Yegor12345/Analog_electronics/Курсовая работа/Фото и скриншоты/Макет фото 2.jpg

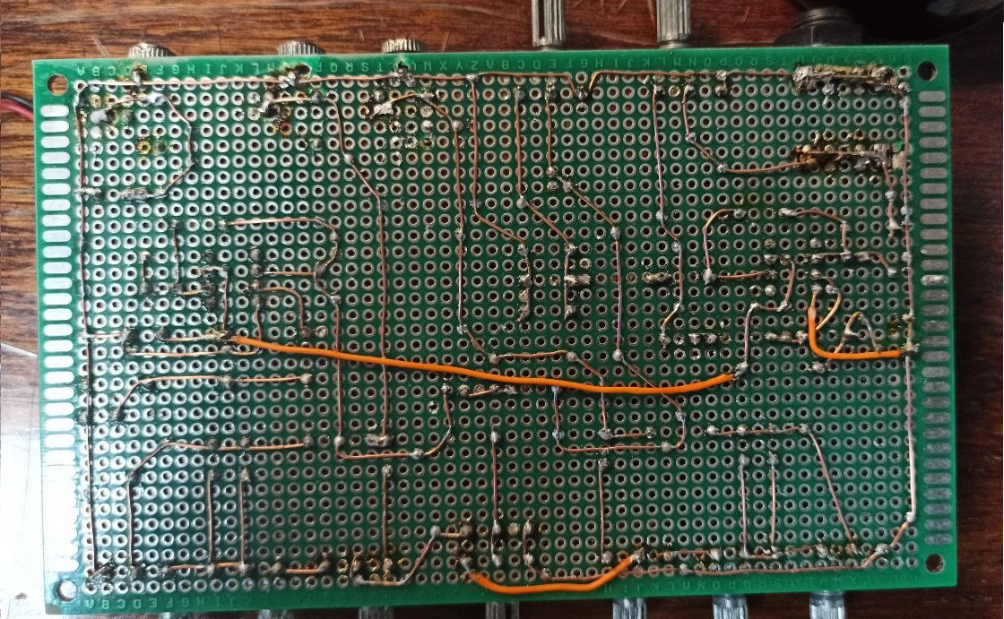
Курсовая работа/Фото и скриншоты/Макет фото 2.jpg
