Yegor12345/Analog_electronics/README.md

# Analog_electronics
Роботи з дисципліни: Аналогова електроніка
