Yegor12345/Analog_electronics/Bodak_lab_1.pdf

МІНІСТЕРСТВО ОСВІТИ І НАУКИ УКРАЇНИ

НАЦІОНАЛЬНИЙ ТЕХНІЧНИЙ УНІВЕРСИТЕТ УКРАЇНИ «КИЇВСЬКИЙ ПОЛІТЕХНІЧНИЙ ІНСТИТУТ

імені ІГОРЯ СІКОРСЬКОГО»

Кафедра: КЕОА

Курс:. “Аналогова електроніка - 1”.

Лабораторна робота № 1

Тема: Дослідження суматора напруг на резисторах, RC ланцюжка та RC фільтрів

Виконав:

Ст. групи ДК-92

бригада №7

Бодак Єгор

Київ 2020

Лабораторна робота №1

Тема: “Дослідження суматора напруг на резисторах, RC ланцюжка та RC фільтрів”

### 1.1. Практичне застосування досліджуваних схем

Суматор напруг на резисторах не є дуже розповсюдженою схемою, але це гарна схема яка

має ефектний результат роботи та дозволяє одержати практику користування макетною платою і

згадати методи розрахунку електричних кіл з джерелами напруги і резисторами. Суматор напруг

можна використовувати у якості найпростішого мікшера для додавання довільних електричних

сигналів у вигляді напруг. А можна на базі суматора напруг створити примітивний калькулятор

для додавання і віднімання чисел (якщо поставити у відповідність кожному числу певну напругу).

Числа на вході можна задавати за допомогою регульованих джерел напруги, а результат зчитувати

за допомогою вольтметру.

RC ланцюжки, дуже широко використовуються в електроніці, оскільки обумовлюють

затримки розповсюдження напруг через схему (напруга змінюється не моментально, а лише після

заряду/розряду ємності, для чого необхідний час, що і обумовлює затримку). Вихід будь якої

лінійної схеми можна замінити моделлю у вигляді джерела напруги з послідовно підключеним

до нього вихідним опором схеми. Вхід будь якої схеми має вхідну ємність. З’єднувальні

провідники на друкованій платі також мають певну ємність. Якщо підключити вихід однієї схеми

до входу іншої схеми, одержимо RC ланцюжок і напруга на вході другої схеми буде змінюватись

не моментально, а у міру заряду-розряду вхідної ємності. Зокрема RC ланцюжки визначають

затримку розповсюдження сигналу всередині мікросхем і врешті решт максимально допустиму

тактову частоту. Також RC ланцюжок можна застосовувати для автоматичного зкидання (ресету)

цифрових схем (наприклад, мікроконтролерів).

RC фільтри є найпростішим типом фільтрів. А фільтри в електроніці використовуються

дуже широко. Наприклад для прибирання з аналогового сигналу шумів та наводок, на вході

аналого-цифрового перетворювача

ХІД РОБОТИ

### 1.2. Завдання на лабораторну роботу

1. Дослідження суматора напруг на резисторах
1.1. Побудувати суматор напруг на 2 входи з резисторів однакових номіналів (рис.1.1). Для

гарного узгодження за напругою та з метою зниження струму, що протікатиме у колі,

номінали резисторів необхідно обирати порядку кількох десятків КОм (50-100КОм);

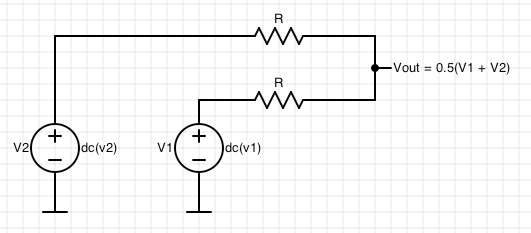
[picture p3: figure]

Рис.1.1. Схема суматора напруг на резисторах

Резистори по 10кОм

1.2. Подати на вхід дві довільні напруги з джерел постійної напруги та за допомогою

вольтметру виміряти напругу на виході суматора. Порівняти одержане значення з

теоретичним результатом Uвих = (U1 + U2)/2. Результати вимірювань занести до

протоколу.

На вхід подаємо напруги 1В та 2В, на виході маємо отримати:

(1В + 2В) / 2 = 1.5 В

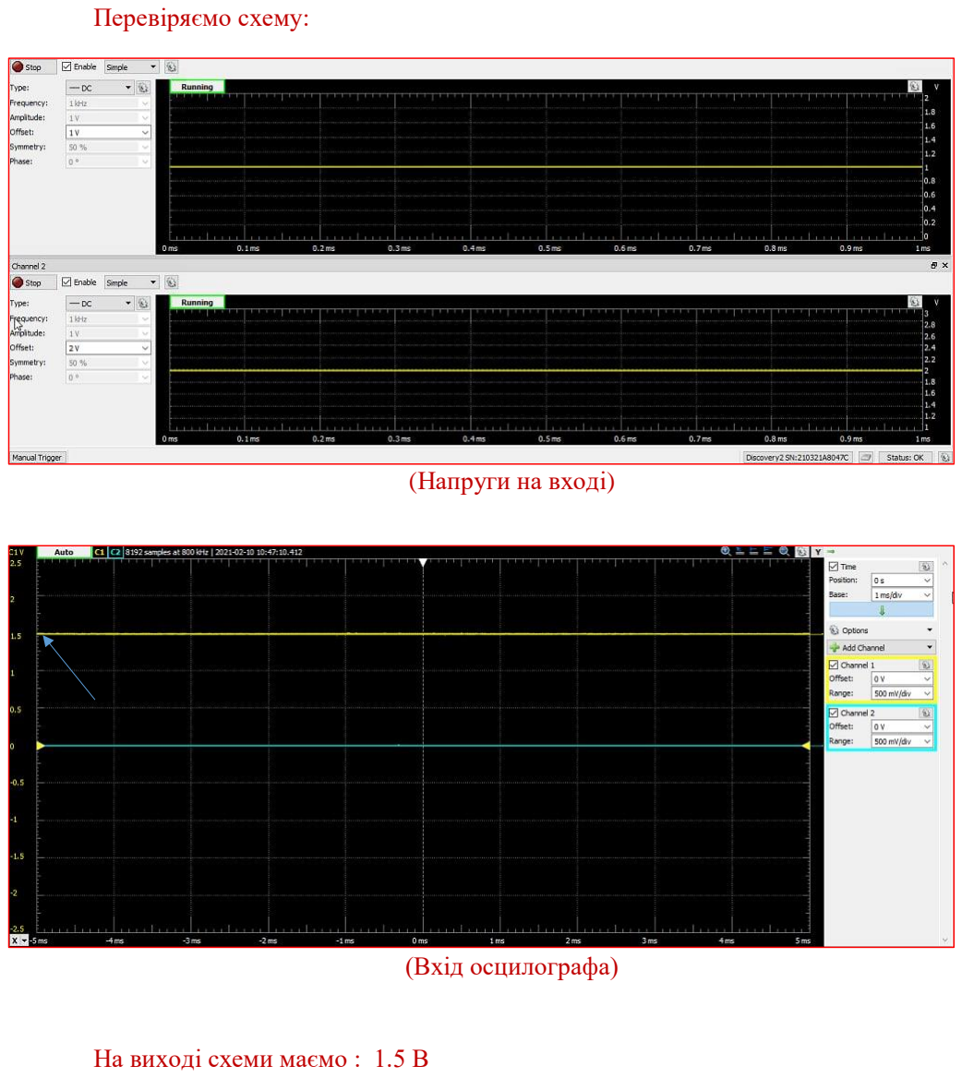
[picture p4: page 4]

Перевіряємо схему:

(Напруги на вході)

(Вхід осцилографа)

На виході схеми маємо : 1.5 В

1.3. Промоделювати роботу суматора в LTSpice для тих же вхідних напруг, що були

використані при проведенні вимірювань на реальних приладах. Порівняти одержані

результати з результатами реальних вимірювань. Результати симуляції (схема, графіки)

занести до протоколу.

LTSpice:

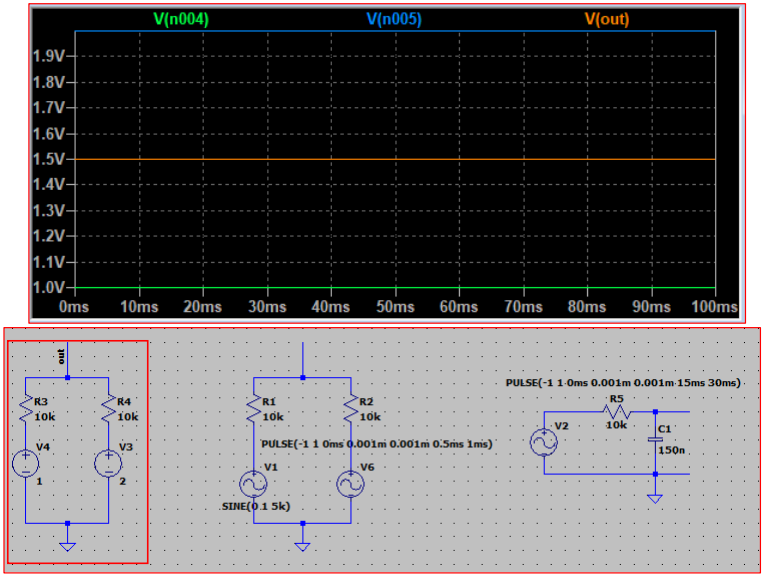
[picture p5: figure]

1.4. Подати на входи суматора два сигнали з генераторів ГЗ-112. Перший сигнал

імпульсний (меандр) з частотою 1 КГц, амплітудою 1В. Другий сигнал синусоїдальний з

частотою 5 КГц, амплітудою 1В. За допомогою двохпроменевого осцилографа необхідно

зафіксувати сигнали на входах суматора (сфотографувати картинку) та сигнал на виході

суматора (сфотографувати картинку). При цьому необхідно записати налаштування

осцилографа на яких ви проводили вимірювання (В/поділку, час/поділку) та параметри

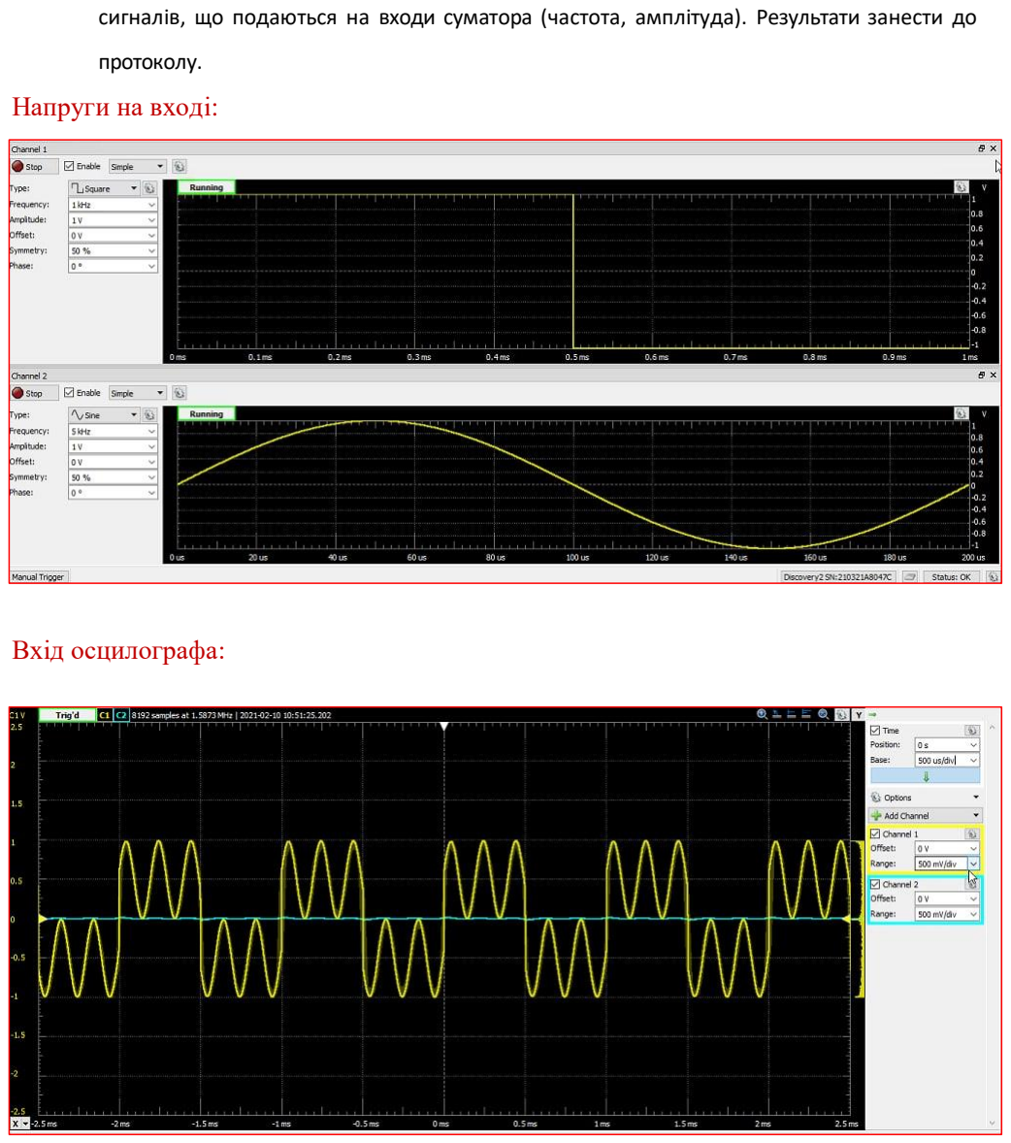
[picture p6: page 6]

сигналів, що подаються на входи суматора (частота, амплітуда). Результати занести до

протоколу.

Напруги на вході:

Вхід осцилографа:

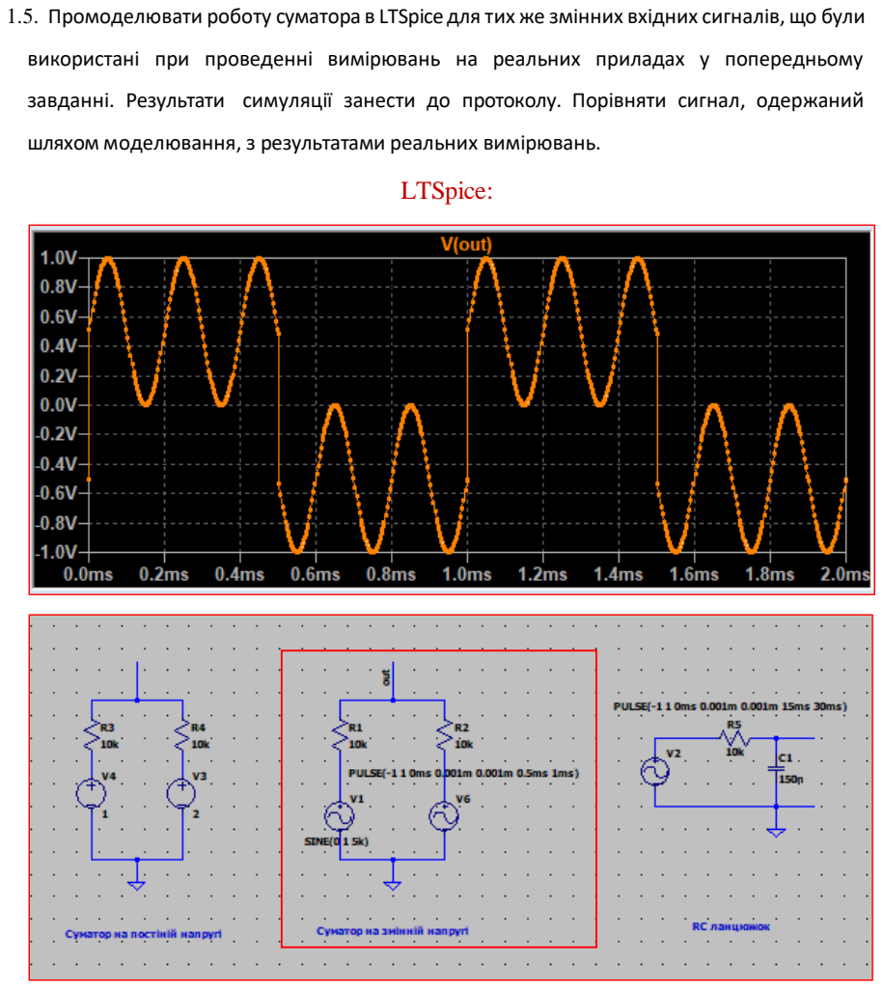
[picture p7: page 7]

1.5. Промоделювати роботу суматора в LTSpice для тих же змінних вхідних сигналів, що були

використані при проведенні вимірювань на реальних приладах у попередньому

завданні. Результати симуляції занести до протоколу. Порівняти сигнал, одержаний

шляхом моделювання, з результатами реальних вимірювань.

LTSpice:

### 2. Дослідження RC ланцюжка

2.1. Скласти схему RC ланцюжка для довільних значень ємності і опору (опір резистора

можна брати порядку кілоома, ємність конденсатора порядку десятківнанофарад).

R= 10кОм

C= 150нФ

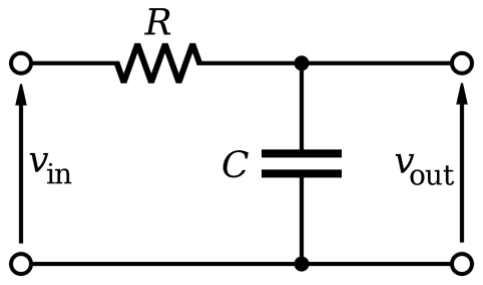
[picture p8: figure]

2.2. Розрахувати тривалість заряду та розряду ємності для цього ланцюжка. Результати

занести до протоколу.

T = R * С = 10 * 10³ * 150 * 10⁻⁹ = 1,5 мс

5Т = 5 * 1,5 = 7,5 мс

2.3 Подати на вхід RC ланцюжка імпульсну напругу з генератора ГЗ-112 з амплітудою 1 В та

такою частотою, щоб період був в 4-6 разів більший за розраховану тривалість заряду-

розряду. На двохпроменевому осцилографі подивитися на вхідний та вихідний сигнали RC

ланцюжка (сфотографувати картинку). Записати налаштування осцилографа на яких ви

проводили вимірювання (В/поділку, час/поділку) та параметри імпульсного сигналу.

Перевірити, що тривалість заряду-розряду дорівнює розрахованому значенню. Результати

вимірювань занести до протоколу.

Знайдемо період більший у 4 рази: 4 * Т = 4 * 7,5 = 30 мс

Розрахуємо частоту: f = 1/T = 1/30 * 10⁻³ = 33.3 H

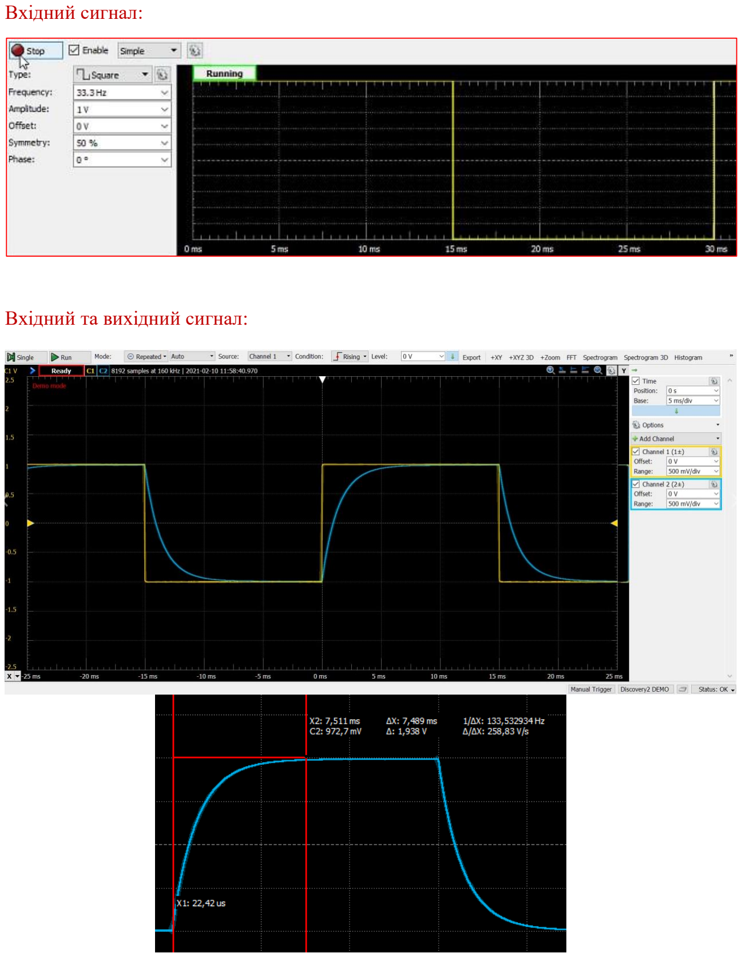
[picture p9: page 9]

Вхідний сигнал:

Вхідний та вихідний сигнал:

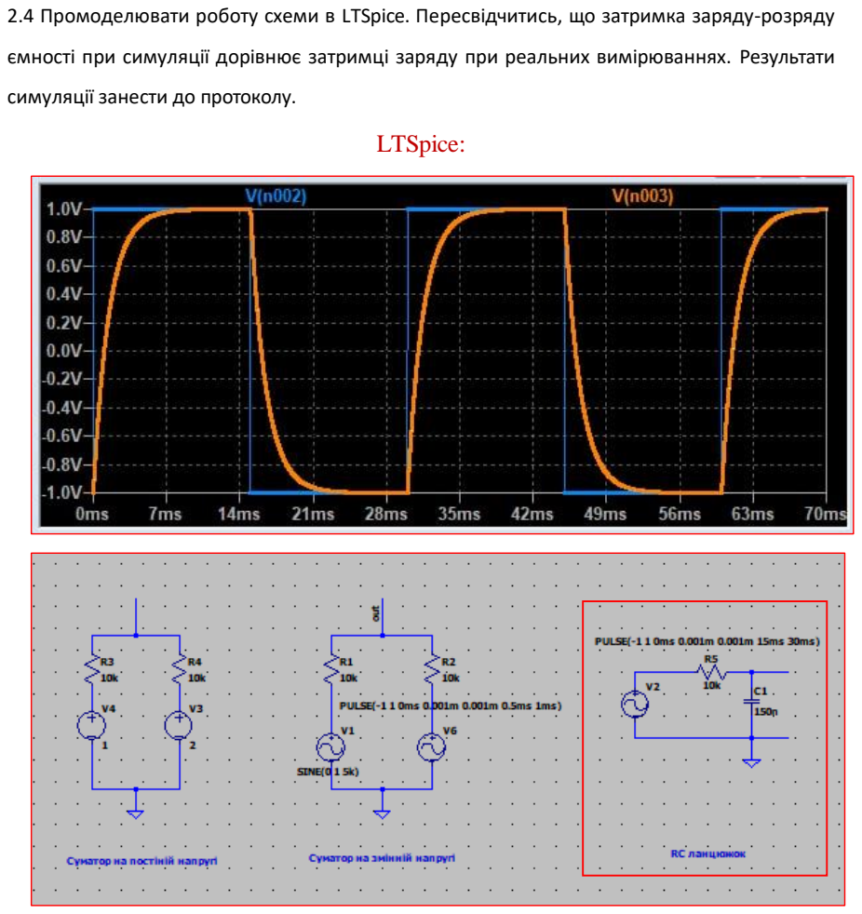
[picture p10: page 10]

2.4 Промоделювати роботу схеми в LTSpice. Пересвідчитись, що затримка заряду-розряду

ємності при симуляції дорівнює затримці заряду при реальних вимірюваннях. Результати

симуляції занести до протоколу.

LTSpice:

3. Дослідження RC фільтру низької частоти.
3.1. Скласти схему RC фільтру низької частоти для довільних значень опору і ємності.
3.2. Розрахувати значення частоти зрізу. Результат занести до протоколу.

fc =

1

## 2πRC

=

1

## 2π ∗ 10 ∗ 10³ ∗ 150 ∗ 10⁻⁹

= 106,1 Гц

3.3. Виміряти амплітудно-частотну характеристику фільтра. Для цього необхідно подати на

вхід фільтру синусоїдальний сигнал з генератора ГЗ-112 з амплітудою 1В та частотою зрізу.

Визначити амплітуду синусоїдального сигналу на виході фільтру. Розрахувати коеф.

передачі за напругою (Ku) для даної частоти (відношення амплітуди вихідного сигналу до

амплітуди вхідного сигналу). Розбити інтервал частот від 0 до частоти зрізу на 3-4 відрізки

і для частот на кінцях цих відрізків визначити значення Ku. При цьому необхідно

слідкувати, щоб амплітуда вхідного сигналу завжди дорівнювала 1 В. Розрахувати Кu для

нульової частоти. Взяти 4-5 значень частоти вище частоти зрізу та визначити для них Ku.

Перевірити, що Ku на частоті близькій до нуля в корінь з двох раз більший ніж Ku на частоті

зрізу. Результат вимірів занести до протоколу у вигляді таблиці частота->Ku. Побудувати

графік амплітудно-частотної характеристики.

3.4. Побудувати графік амплітудно-частотної характеристики в LTSpice. Додати цей графік до

протоколу. Порівняти з графіком одержаним для реальних вимірювань.

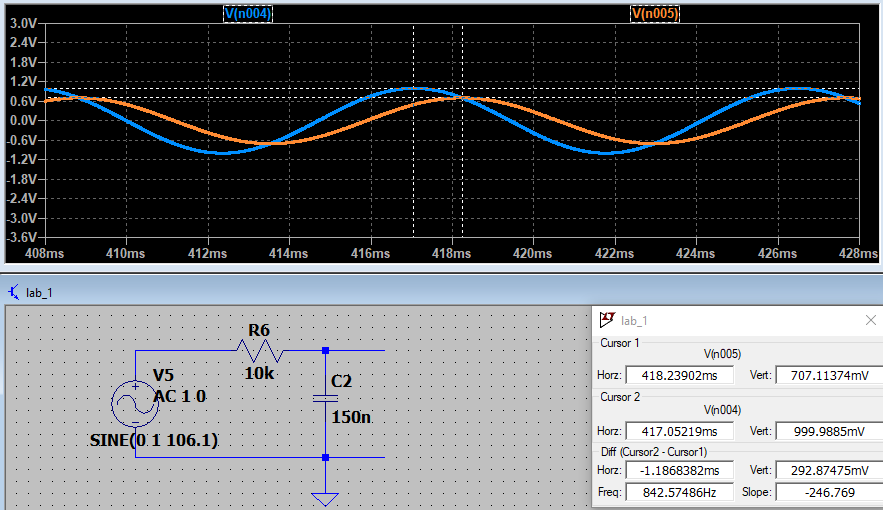
[picture p11: figure]

Амплітуда вхідного і вихідного сигналу схеми в LTSpice на частоті зрізу відповідно

дорівнює:

Uвх = 0.9 ≈ 1 В

Uвих = 0.7 В

З підвищенням частоти ємнісний опір конденсатора падає і схема працює як

подільник напруги, частотою зрізу вважається така частота де падіння напруги

дорівнює 1/√2 ≈ 0.707, тим самим ми підтвердили вірність обрахованої попередньо

частоти.

К = Uвых/Uвх

Коефіцієнт передачі на частоті зрізу має дорівнювати 1/√2 ≈ 0.7, можемо ще раз

впевнитись вірності даних: Кчз = 0,7 / 1 = 0,7 В.

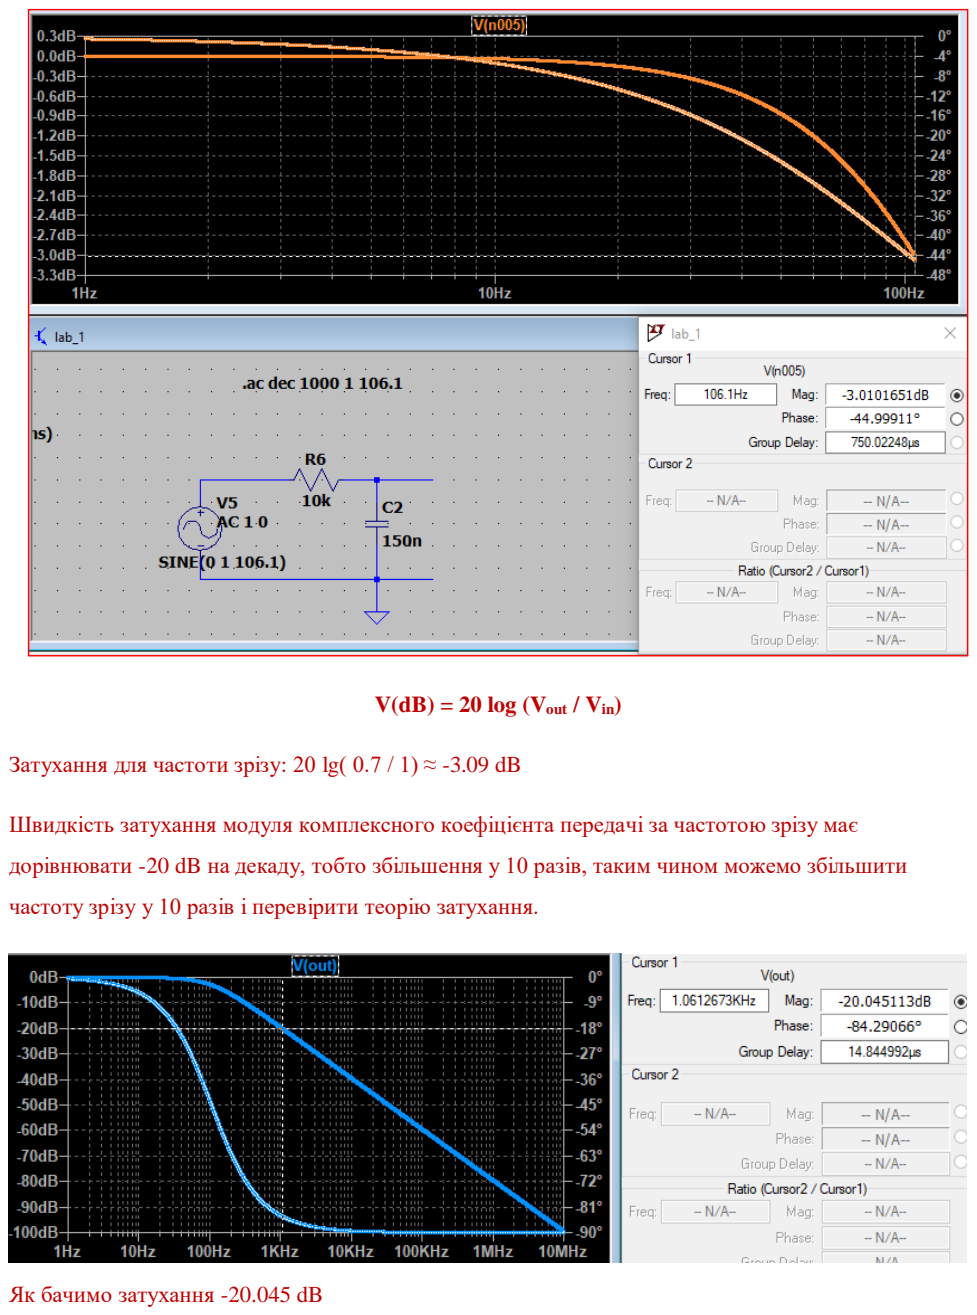
[picture p12: page 13]

V(dB) = 20 log (Vout / Vin)

Затухання для частоти зрізу: 20 lg( 0.7 / 1) ≈ -3.09 dB

Швидкість затухання модуля комплексного коефіцієнта передачі за частотою зрізу має

дорівнювати -20 dB на декаду, тобто збільшення у 10 разів, таким чином можемо збільшити

частоту зрізу у 10 разів і перевірити теорію затухання.

Як бачимо затухання -20.045 dB

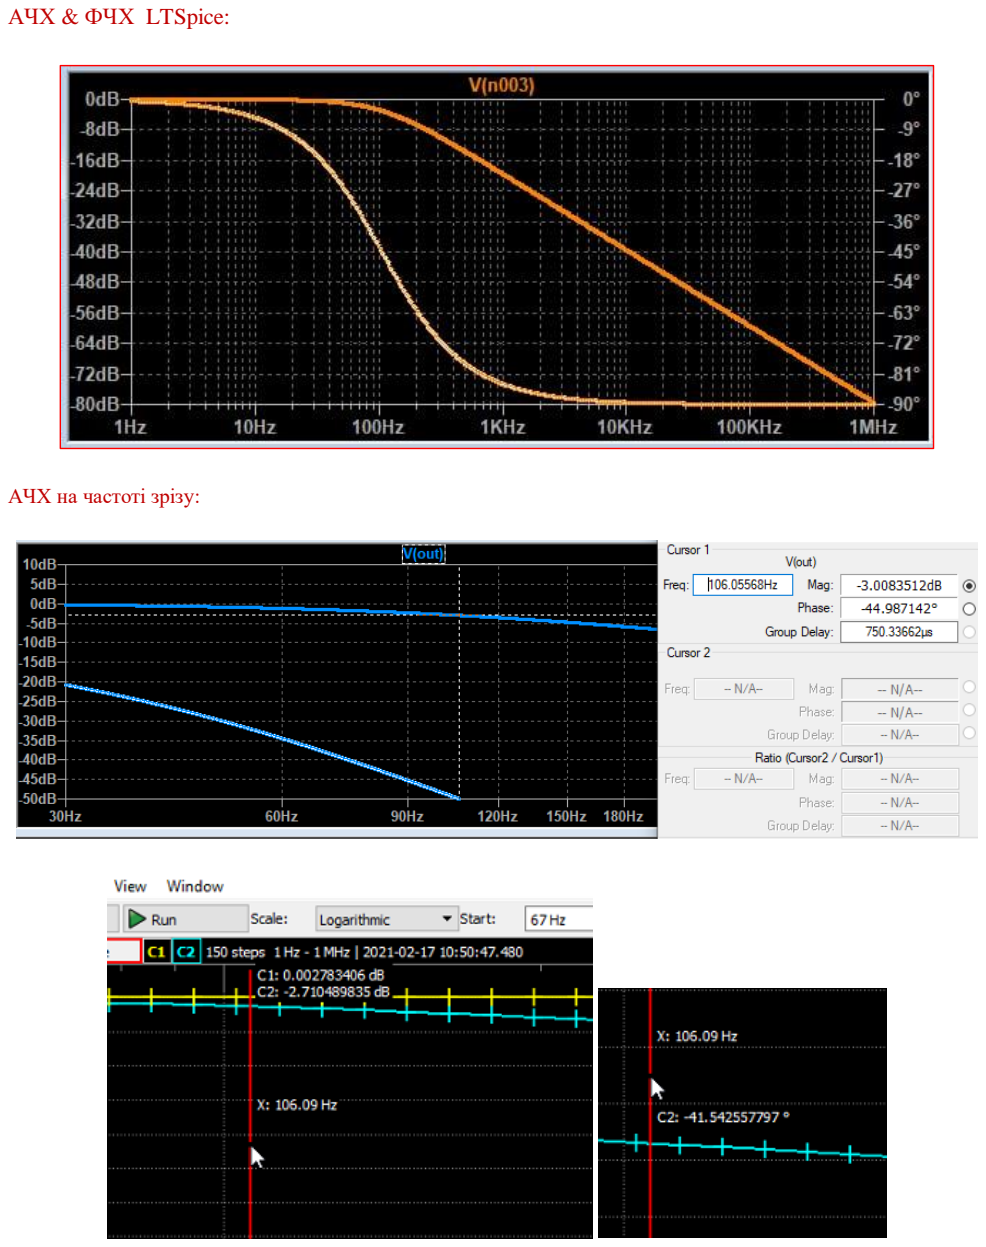
[picture p13: page 14]

АЧХ & ФЧХ LTSpice:

АЧХ на частоті зрізу:

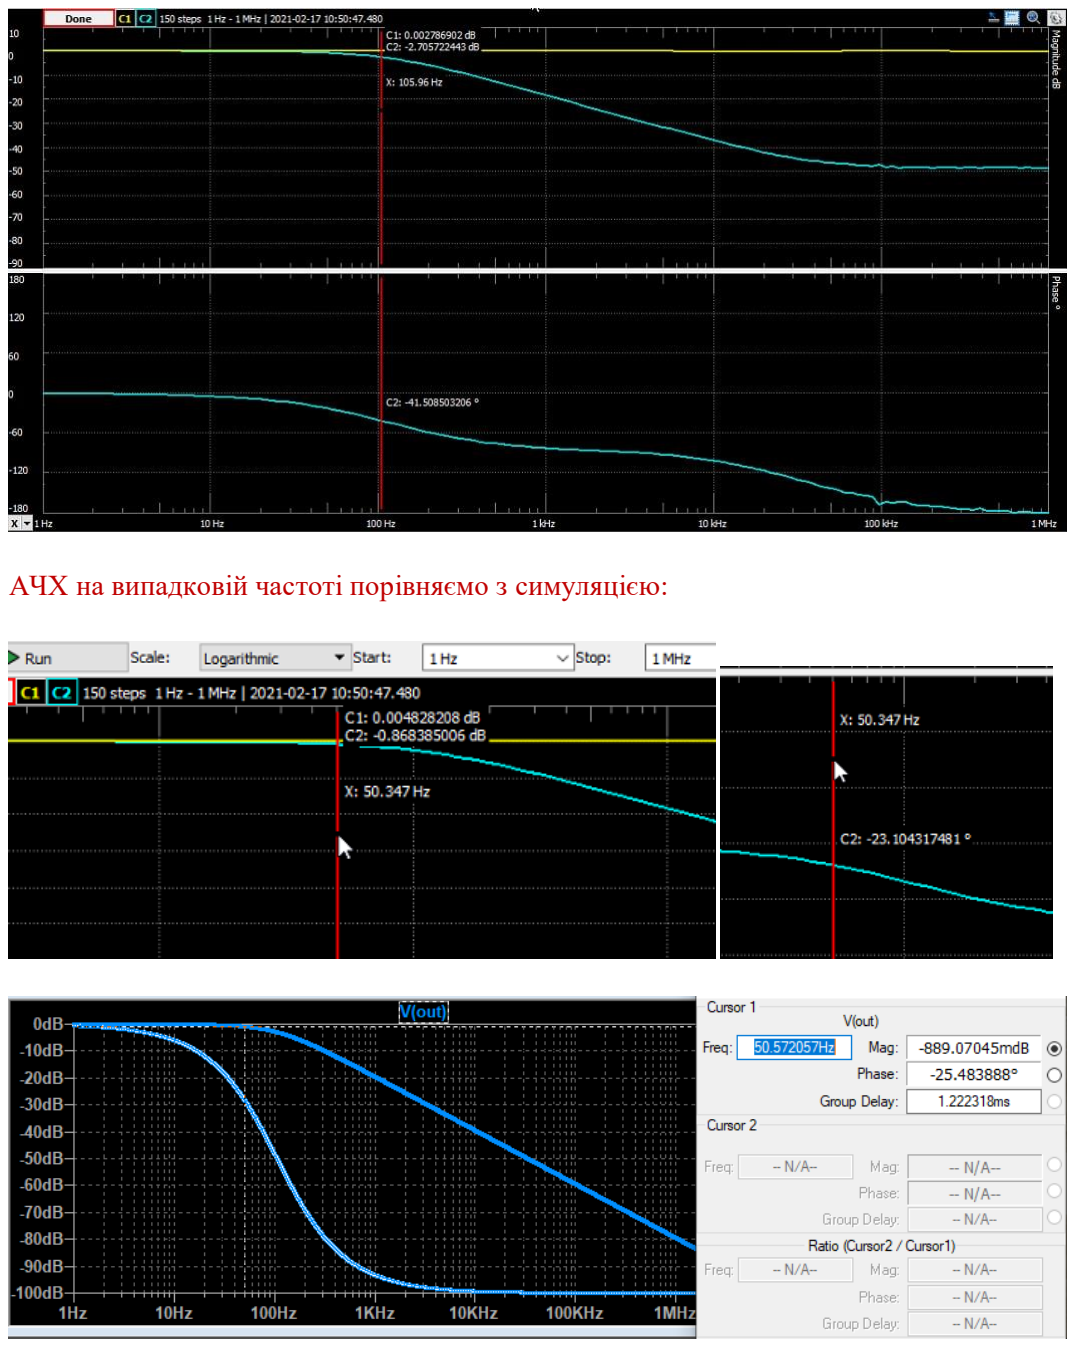
[picture p14: page 15]

АЧХ на випадковій частоті порівняємо з симуляцією:

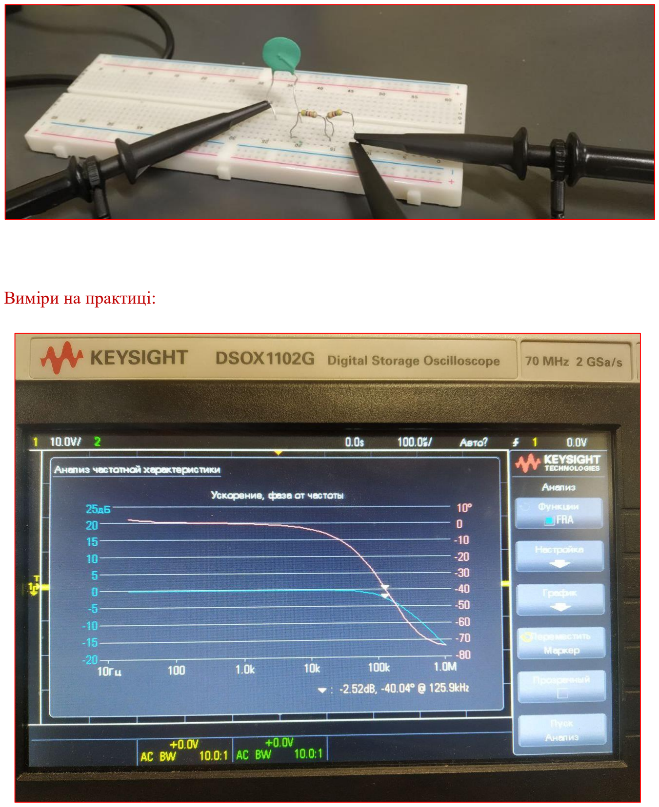
[picture p15: page 16]

Виміри на практиці:

Висновки

На цій лабораторній роботі я провів виміри та розрахунки суматора на постійні і

змінній напругі, що не виявилось складним, але спостерігати сумування сигналів

типу синус та меандр було цікаво . Також я провів дослід з RC ланцюгом,

розрахував параметр заряду-розряду конденсатора, спостерігав як це явище впливає

на вхідний сигнал, схему знаходжу дуже корисною наприклад для формування і

згладження сигналів. Крім цього я дослід інтегруючий RC фільтр , моєю задачею

було розрахувати параметри та перевірити на практиці те що коефіцієнт передачі за

напругою на частоті зрізу має дорівнювати 1/√2, добре що розрахунки зійшлись.

Пояснити це явище не складно, з курсу ОТК пам’ятаю, що при подачі змінної

напруги на конденсатор з малою частотою це обрив , а так як конденсатор

підключений на землю можемо вважати що вся напруга піде через резистор, у

випадку подачі напруги на високій частоті конденсатор закоротка і це свідчить про

те що весь сигнал з резистора піде на землю і на виході матимемо нуль. Тому такий

фільтр називається інтегруючим , всі низькі частоти до частоти зрізу не

спотворюються. На частоті зрізу реактивний опір конденсатор зменшується і ми

отримуємо подільник напруги.

### 1.4. Контрольні запитання

1. Виведіть формулу напруги на виході суматора напруг на резисторах з трьома входами;
2. Які недоліки суматора напруг на резисторах?
3. Виведіть формули заряду-розряду ємності RC ланцюжка;
4. Намалюйте графік заряду-розряду ємності RC ланцюжка;
5. Що таке постійна часу RC-ланцюжка? Як вона виражається через R і C?
6. Як розрахувати час заряду/розряду ємності RC ланцюжка?
7. Де застосовується RC ланцюжок?
8. Намалюйте схеми RC фільтрів високої і низької частоти;
9. Що таке амплітудо-частотна характеристика?
10. Намалюйте амплітудно-частотні характеристики RC фільтрів високої і низькоїчастоти;
11. Напишіть формули частот зрізу RC фільтрів високої і низької частоти;
12. На якій полосі частот RC фільтр високої частоти пропускає сигнали? На якій полосі

не пропускає?

13. На якій полосі частот RC фільтр низької частоти пропускає сигнали? На якій полосі

не пропускає?

15. Яка швидкість затухання сигналу в RC фільтрів високої і низької частоти?
16. Що таке децибели? Як перейти від відношення в разах до відношення в децибелах?
17. Де використовують децибели?
18. Де використовують фільтри?
