Yegor12345/Analog_electronics/RGR/Трасування - Верхня сторона плати.JPG

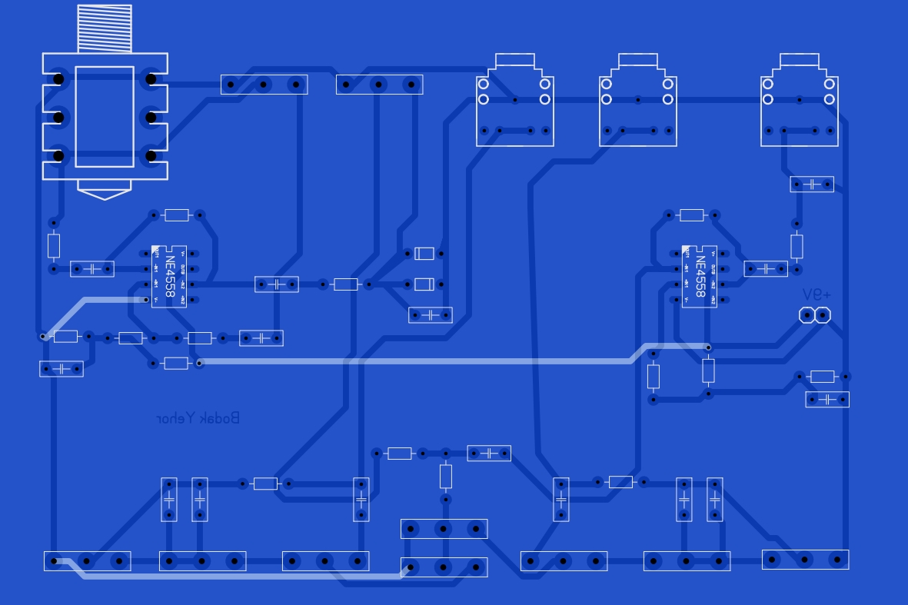
RGR/Трасування - Верхня сторона плати.JPG
