Yegor12345/Analog_electronics/RGR/Трасування - Нижня сторона плати.JPG

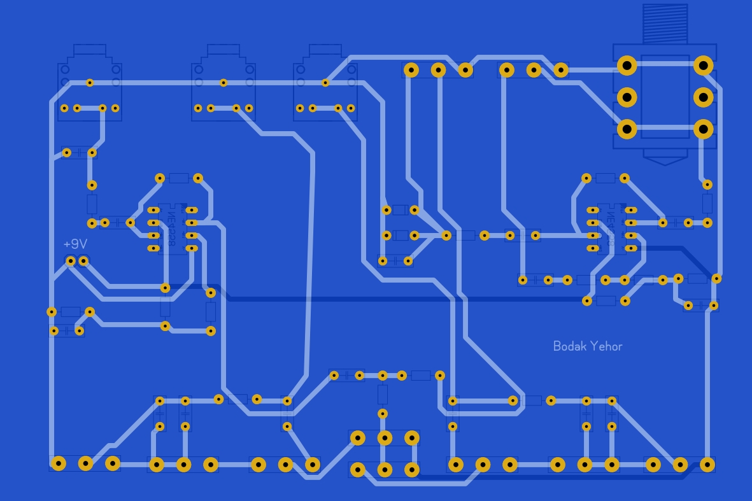
RGR/Трасування - Нижня сторона плати.JPG
