Yegor12345/Analog_electronics/RGR/Фото макету.jpg

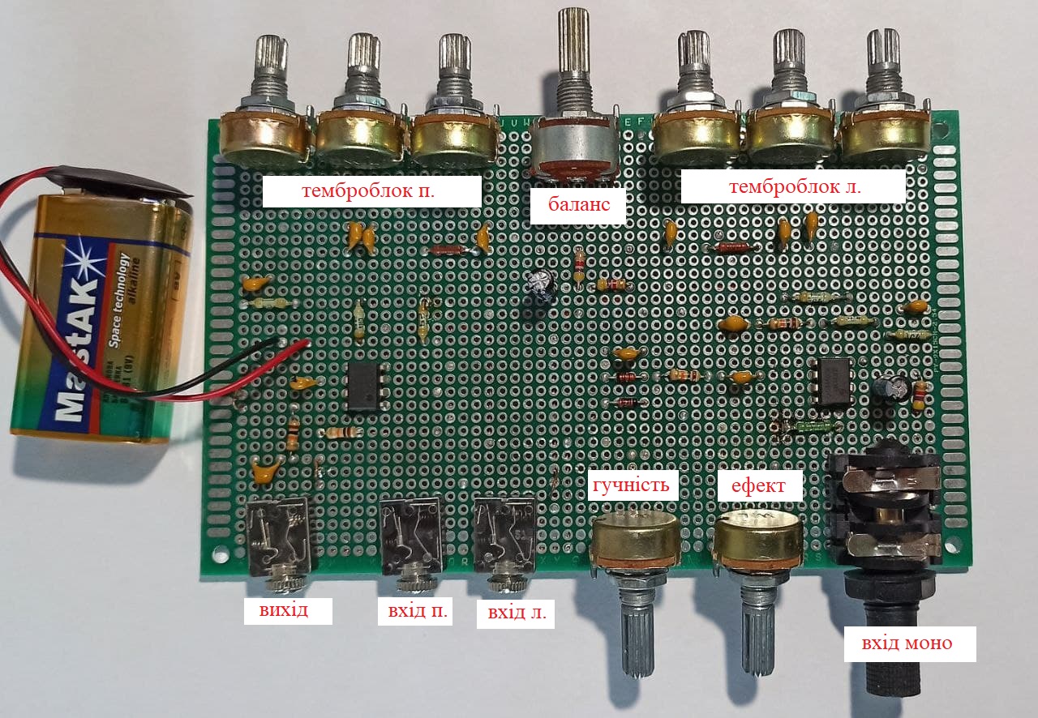
RGR/Фото макету.jpg
