Yegor12345/Analog_electronics/Курсовая работа/Фото и скриншоты/3Д плата.PNG

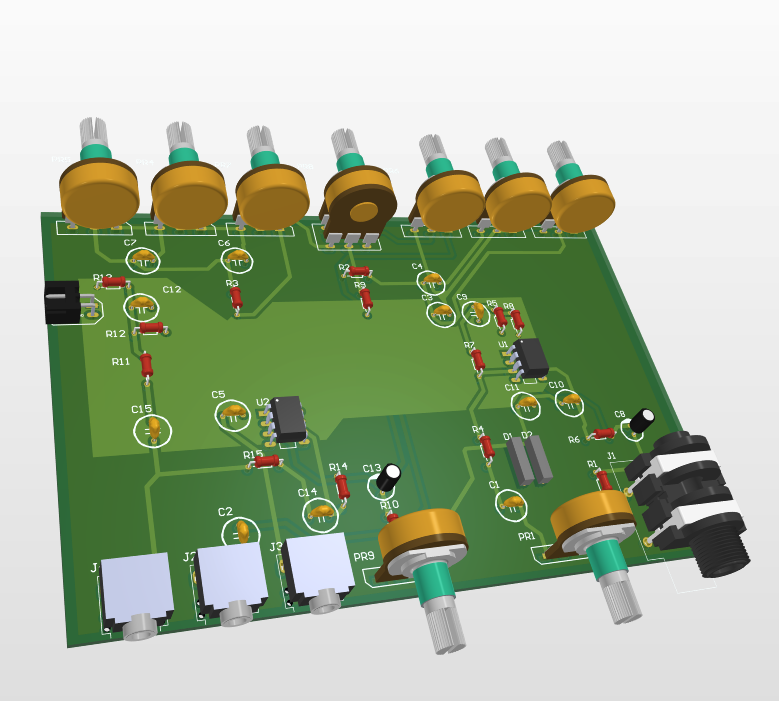
Курсовая работа/Фото и скриншоты/3Д плата.PNG
