Yegor12345/Analog_electronics/Курсовая работа/Фото и скриншоты/Другий шар.PNG

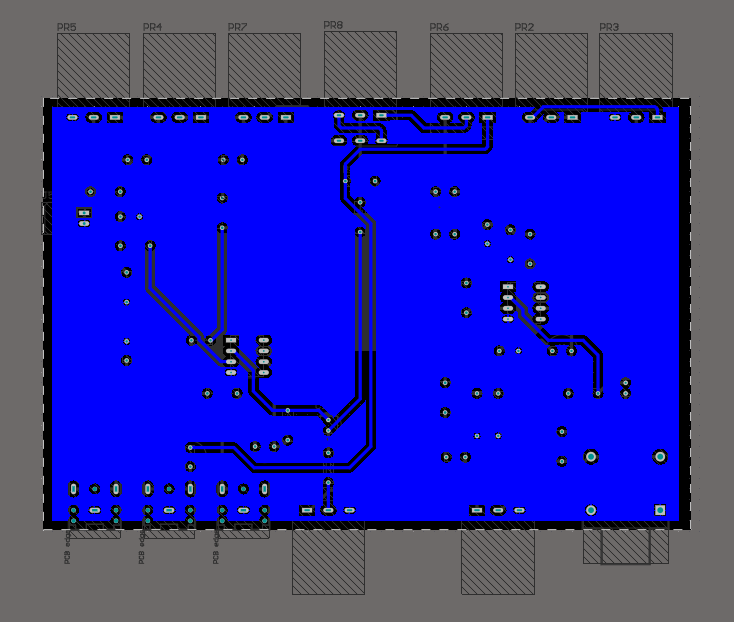
Курсовая работа/Фото и скриншоты/Другий шар.PNG
