Yegor12345/Analog_electronics/Курсовая работа/Фото и скриншоты/Макет фото 3.jpg

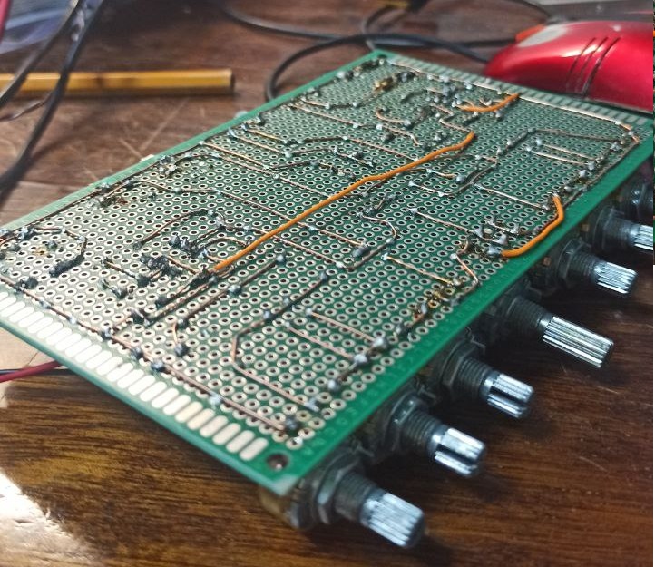
Курсовая работа/Фото и скриншоты/Макет фото 3.jpg
