Yegor12345/Analog_electronics/Курсовая работа/Фото и скриншоты/Перший шар.PNG

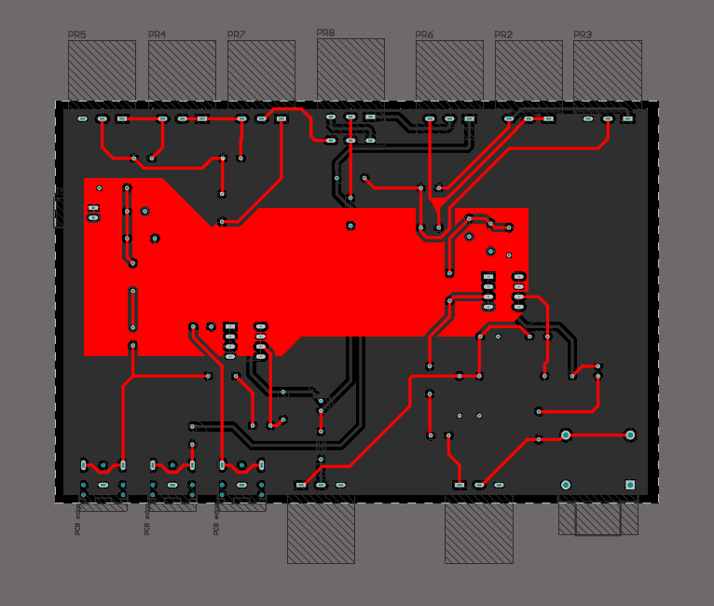
Курсовая работа/Фото и скриншоты/Перший шар.PNG
