Yegor12345/Analog_electronics/Курсовая работа/Bill Of Materials.xlsx

LibRef | Manufacturer | Comment | Description | Designator | Supplier Part Number 1 | Quantity | Supplier 1 | Pricing 1
C320C103K3G5TA | KEMET | 0.01uF | Capacitor Multi-layer Ceramic 0.01uF 10% 25V 2-Pin Through Hole Bulk | C1 | C320C103K3G5TA-ND | 1 | Digi-Key | 1=0,57000, 10=0,40100, 50=0,30320, 100=0,26400, 500=0,19558, 1000=0,16624, 2500=0,15646, 5000=0,14668 (USD)
RCER71H223K0DBH03A | Murata | 22nF | Cap Ceramic 0.022uF 50V X7R 10% Radial 2.5mm 125C Automotive Ammo | C2, C3, C4, C5, C6, C7 | 490-7531-1-ND | 6 | Digi-Key | 1=0,51000, 10=0,35600, 50=0,24940, 100=0,21380, 500=0,16038, 1000=0,13543 (USD)
NEV.56M50 | NTE Electronics | 0.05uF | CAPACITOR .56MFD 50V RADIAL | C8, C13 | 33C5581 | 2 | Newark | 1=0,61100, 10=0,36000, 25=0,28600, 50=0,21700, 100=0,17700, 500=0,14600, 1000=0,12200, 2500=0,10900 (USD)
FG18X7R1E105KRT00 | TDK | 1uF | Capacitor Ceramic 1uF 25V X7R 10% 2.5mm Bulk | C9, C10, C12, C14 | 445-180204-ND | 4 | Digi-Key | 1=0,38000, 10=0,25900, 50=0,17240, 100=0,14660, 500=0,10348, 1000=0,09055, 2500=0,08624, 5000=0,07977 (USD)
C320C102K3G5TA | KEMET | 0.001uF | Capacitor Multi-layer Ceramic 0.001uF 10% 25V 2-Pin Through Hole Bulk | C11, C15 | C320C102K3G5TA-ND | 2 | Digi-Key | 1=0,43000, 10=0,29500, 50=0,20680, 100=0,17720, 500=0,13290, 1000=0,11223, 2500=0,10633, 5000=0,10042 (USD)
1N914 | ON Semiconductor / Fairchild | Diode 1N914 | 1N914 Series 500 mW 100 V Max Reverse Voltage Small Signal Diode - DO-35 | D1, D2 | 1N914FS-ND | 2 | Digi-Key | 1=0,10000, 10=0,08200, 100=0,04470, 500=0,02752, 1000=0,01876, 2000=0,01595, 5000=0,01438, 10000=0,01251, 50000=0,01033 (USD)
SJ-63072J | CUI Devices | SJ-63072J | 6.35 mm, Stereo, Right Angle, Through Hole, Isolated Ground, Audio Jack Connector | J1 | 2223-SJ-63072J-ND | 1 | Digi-Key | 1=1,88000, 10=1,70700, 100=1,46350, 1000=1,04535 (USD)
SJ1-3523NG | CUI Devices | SJ1-3523NG | 3.5 mm, Stereo, Right Angle, Through Hole, Isolated Ground, Audio Jack Connector | J2, J3, J4 | CP1-3523NG-ND | 3 | Digi-Key | 1=0,81000, 10=0,74000, 1000=0,44440 (USD)
1841630000 | Weidmuller | Power | Conn Shrouded Header HDR 2 POS 3.5mm Solder RA Thru-Hole Box | J5 | 79T5409 | 1 | Newark | 1=1,40000, 10=1,02000, 25=0,94200, 50=0,85600, 100=0,85200, 250=0,71700 (USD)
502-0417 | NTE Electronics | pot. 100k | Potentiometer 1/4 Watt 100K Ohm 24MM 6MM Shaft Diameter 1.18 Inch Shaft Length Combo Terminals | PR1, PR9 | 67AH5103 | 2 | Newark | 1=2,48000 (USD)
502-0413 | NTE Electronics | pot. 50K | Potentiometer 1/4 Watt 50K Ohm 24MM 6MM Shaft Diameter 1.18 Inch Shaft Length Combo Terminals | PR2, PR3, PR4, PR5, PR6, PR7 | 67AH5098 | 6 | Newark | 1=1,80000 (USD)
R1610GA | HT | pot. 1M | Potentiometer 1M Ohm | PR8 | 29562 | 1 | Electonoff | 1=1,00000 (USD)
CFS1/4CT52R472J | KOA Speer | 4.7k | Res Carbon Film 4.7K Ohm 5% 0.25W(1/4W) -450ppm/C to 350ppm/C Conformal Coated AXL T/R | R1, R9, R10 | 2019-CFS1/4CT52R472JCT-ND | 3 | Digi-Key | 1=0,10000, 10=0,04600, 25=0,03360, 50=0,02560, 100=0,01890, 250=0,01440, 500=0,01152, 1000=0,00848 (USD)
CFS1/4CT52R104G | KOA Speer | 100k | Carbon Film Resistors - Through Hole 100K OHM 2% 1/4W | R2, R3 | 2019-CFS1/4CT52R104GCT-ND | 2 | Digi-Key | 1=0,10000, 10=0,07800, 25=0,05400, 50=0,04200, 100=0,03000, 250=0,02340, 500=0,01860, 1000=0,01320 (USD)
CFP1/4CT52R103J | KOA Speer | 10k | Carbon Film Resistors - Through Hole 10K ohm 5% FLAMEPROOF | R4, R14, R15 | 2019-CFP1/4CT52R103JCT-ND | 3 | Digi-Key | 1=0,14000, 10=0,12100, 25=0,08800, 50=0,06380, 100=0,04730, 250=0,03632, 500=0,02860, 1000=0,01980 (USD)
CFS1/4CT52R105J | KOA Speer | 1M | Carbon Film Resistors - Through Hole 1M OHM 5% 1/4W | R5, R6, R7, R8, R11, R12, R13 | 2019-CFS1/4CT52R105JCT-ND | 7 | DigiKey | 1=0,10000, 10=0,04600, 25=0,03360, 50=0,02560, 100=0,01890, 250=0,01440, 500=0,01152, 1000=0,00848 (USD)
LM741CN/NOPB | TI National Semiconductor | LM741 | OP Amp Single GP ±18V 8-Pin PDIP Rail | U1, U2 | LM741CNNS/NOPB-ND | 2 | Digi-Key | 1=0,94000, 10=0,82600, 25=0,77560, 100=0,63290, 250=0,58788, 500=0,50032, 1000=0,40026, 2500=0,39412 (USD)
 |  |  |  |  |  | Total 1: | 32,592 (USD)
