Yegor12345/Analog_electronics/Курсовая работа/Altium Designer/Модель Fusion/Pot mono.step

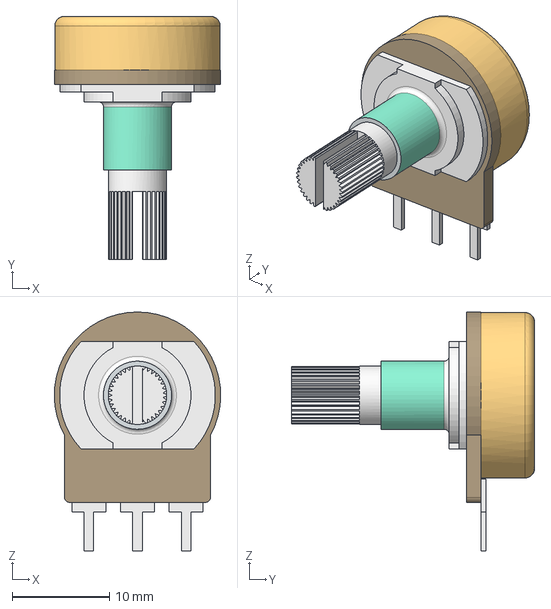
[picture p40: CAD file, 2021-05-29]
Курсовая работа/Altium Designer/Модель Fusion/Pot mono.step
17.1 x 25.0 x 24.5 mm
