Yegor12345/Analog_electronics/Курсовая работа/Altium Designer/Модель Fusion/R - 2 red.step

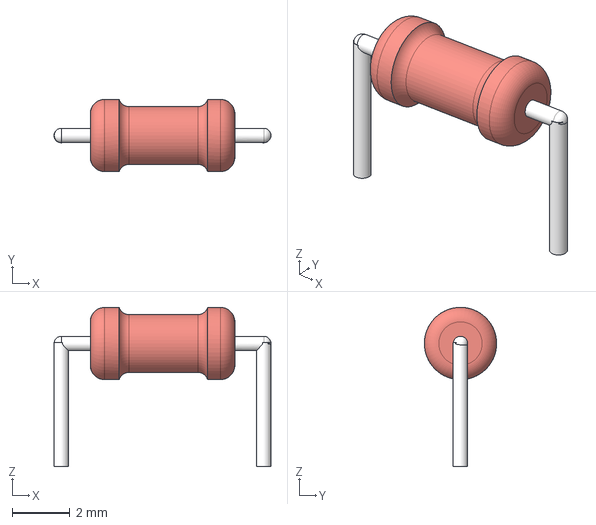
[picture p41: CAD file, 2021-05-29]
Курсовая работа/Altium Designer/Модель Fusion/R - 2 red.step
7.50 x 2.50 x 5.51 mm
