Yegor12345/Analog_electronics/Курсовая работа/Altium Designer/Модель Fusion/Jack 6.35.step

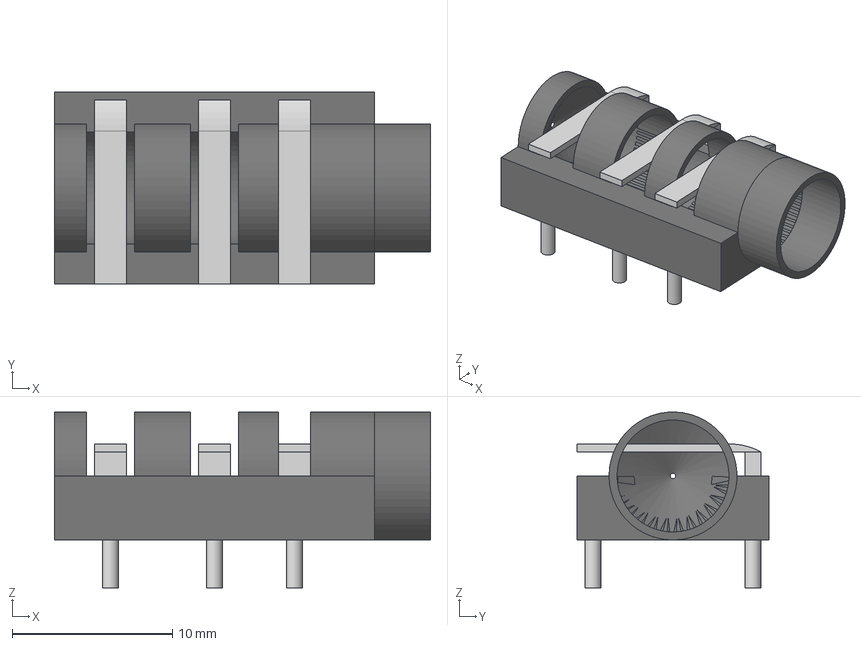
[picture p42: CAD file, 2021-05-29]
Курсовая работа/Altium Designer/Модель Fusion/Jack 6.35.step
23.5 x 12.0 x 11.0 mm
