Yegor12345/Analog_electronics/Курсовая работа/Altium Designer/Модель Fusion/Electrolit.step

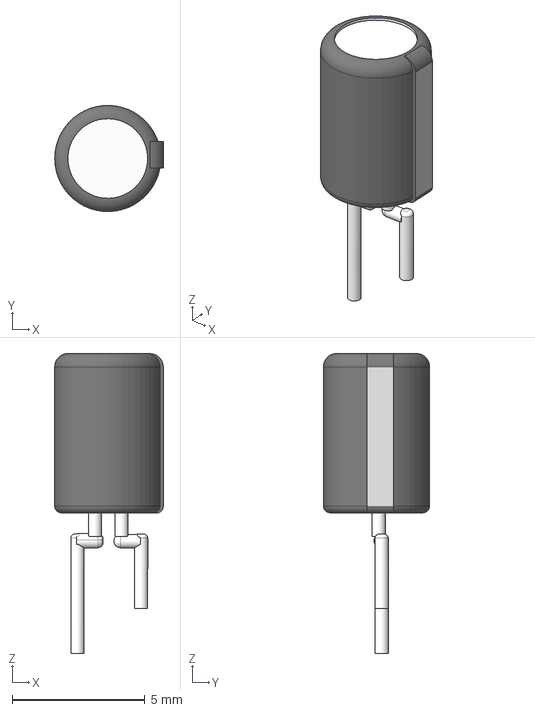
[picture p43: CAD file, 2021-05-29]
Курсовая работа/Altium Designer/Модель Fusion/Electrolit.step
4.09 x 4.00 x 11.3 mm
