Yegor12345/Analog_electronics/Курсовая работа/Altium Designer/Модель Fusion/Keramica.step

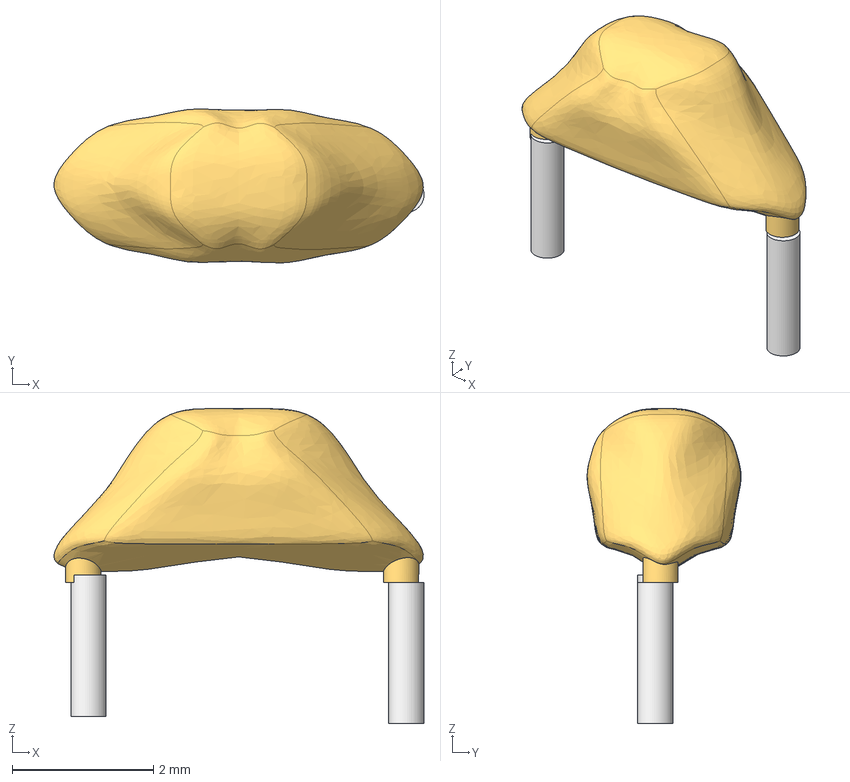
[picture p44: CAD file, 2021-05-29]
Курсовая работа/Altium Designer/Модель Fusion/Keramica.step
5.24 x 2.18 x 4.46 mm
