Yegor12345/Analog_electronics/Курсовая работа/Altium Designer/Модель Fusion/R-1 yellow.step

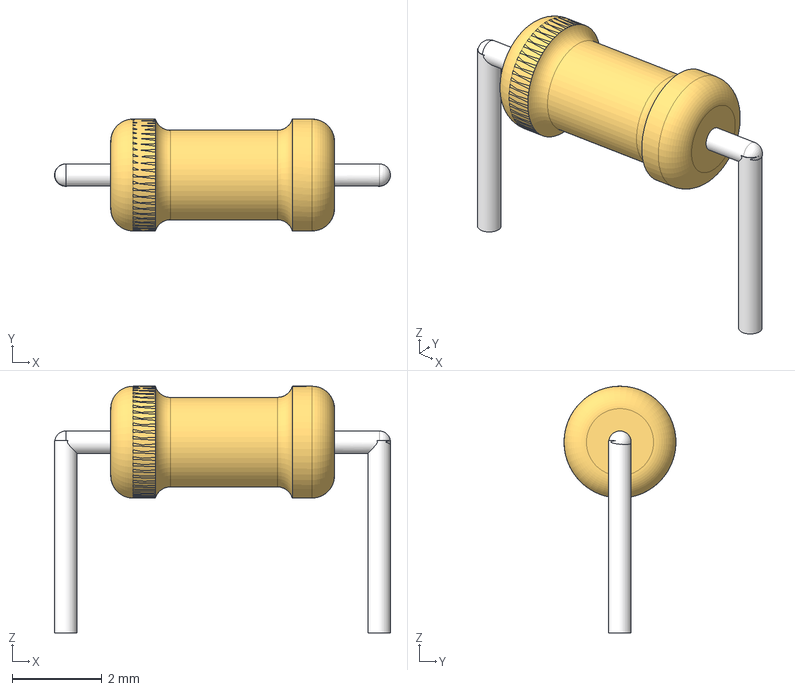
[picture p45: CAD file, 2021-05-29]
Курсовая работа/Altium Designer/Модель Fusion/R-1 yellow.step
7.50 x 2.50 x 5.51 mm
