Yegor12345/Analog_electronics/Курсовая работа/Altium Designer/Модель Fusion/Jack 6.3.step

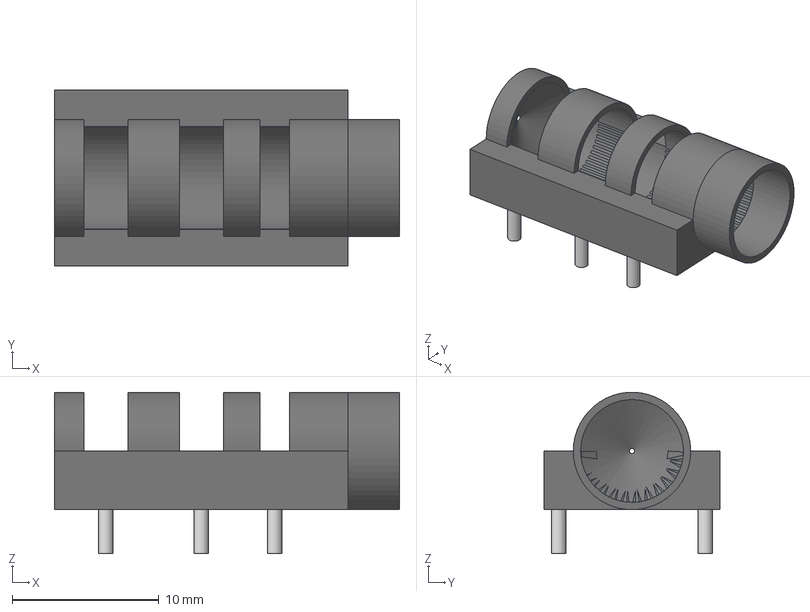
[picture p46: CAD file, 2021-05-29]
Курсовая работа/Altium Designer/Модель Fusion/Jack 6.3.step
23.5 x 12.0 x 11.0 mm
