Yegor12345/Analog_electronics/Курсовая работа/Altium Designer/Модель Fusion/Pot stereo.step

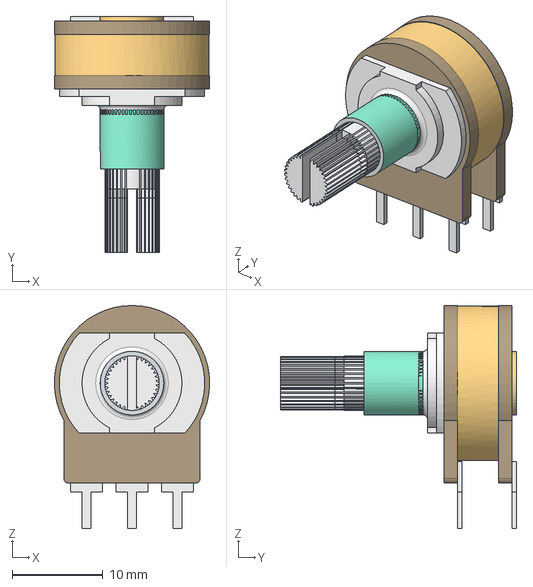
[picture p47: CAD file, 2021-05-29]
Курсовая работа/Altium Designer/Модель Fusion/Pot stereo.step
17.1 x 26.0 x 24.5 mm
