Yegor12345/Analog_electronics/Курсовая работа/Altium Designer/Модель Fusion/Diose.step

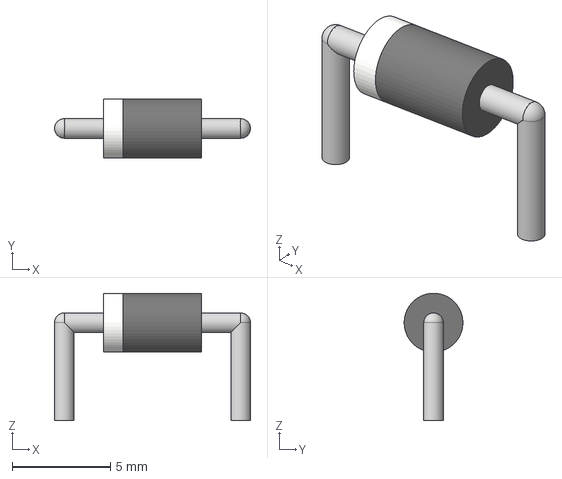
[picture p48: CAD file, 2021-05-29]
Курсовая работа/Altium Designer/Модель Fusion/Diose.step
10.00 x 3.00 x 6.50 mm
