Yegor12345/Analog_electronics/Курсовая работа/Altium Designer/Модель Fusion/LM741.step

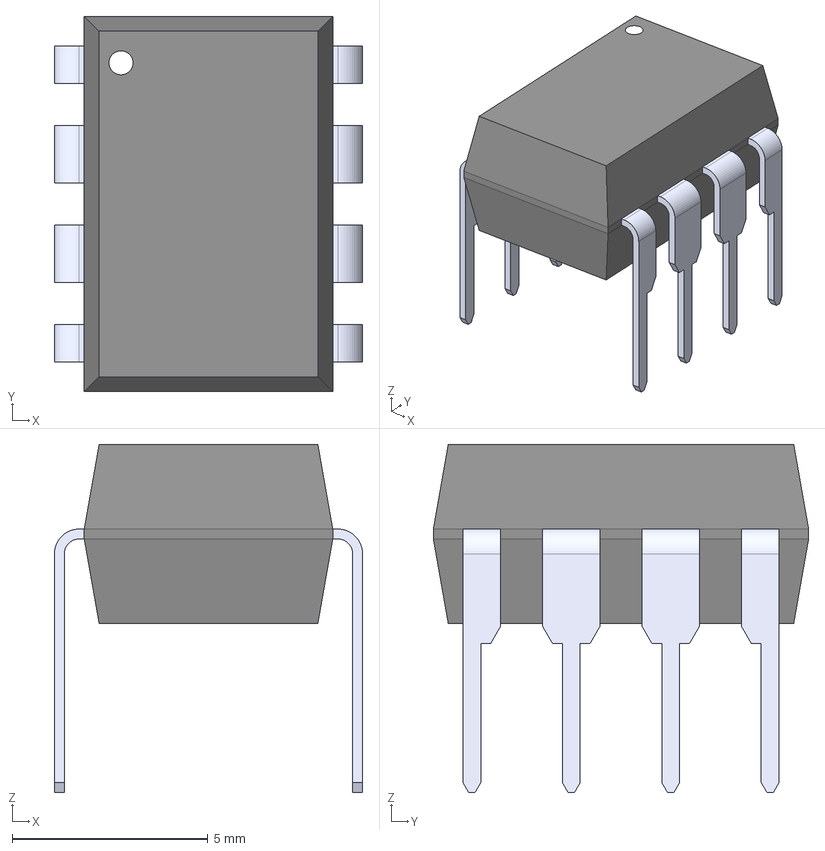
[picture p49: CAD file, 2021-05-29]
Курсовая работа/Altium Designer/Модель Fusion/LM741.step
7.87 x 9.59 x 8.89 mm
