Yegor12345/Analog_electronics/Курсовая работа/Altium Designer/Модель Fusion/Jack 3.5.step

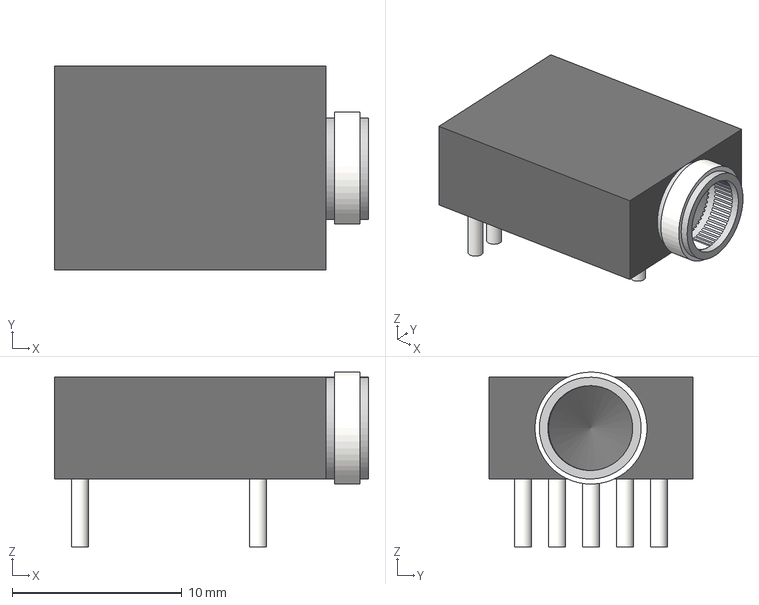
[picture p50: CAD file, 2021-05-29]
Курсовая работа/Altium Designer/Модель Fusion/Jack 3.5.step
18.5 x 12.0 x 10.3 mm
