Yegor12345/Analog_electronics/(list of files, cad)

Other CAD files:
Курсовая работа/Altium Designer/Модель Fusion/R -3 gren.step
