Yegor12345/Analog_electronics/Курсовая работа/Схема.pdf

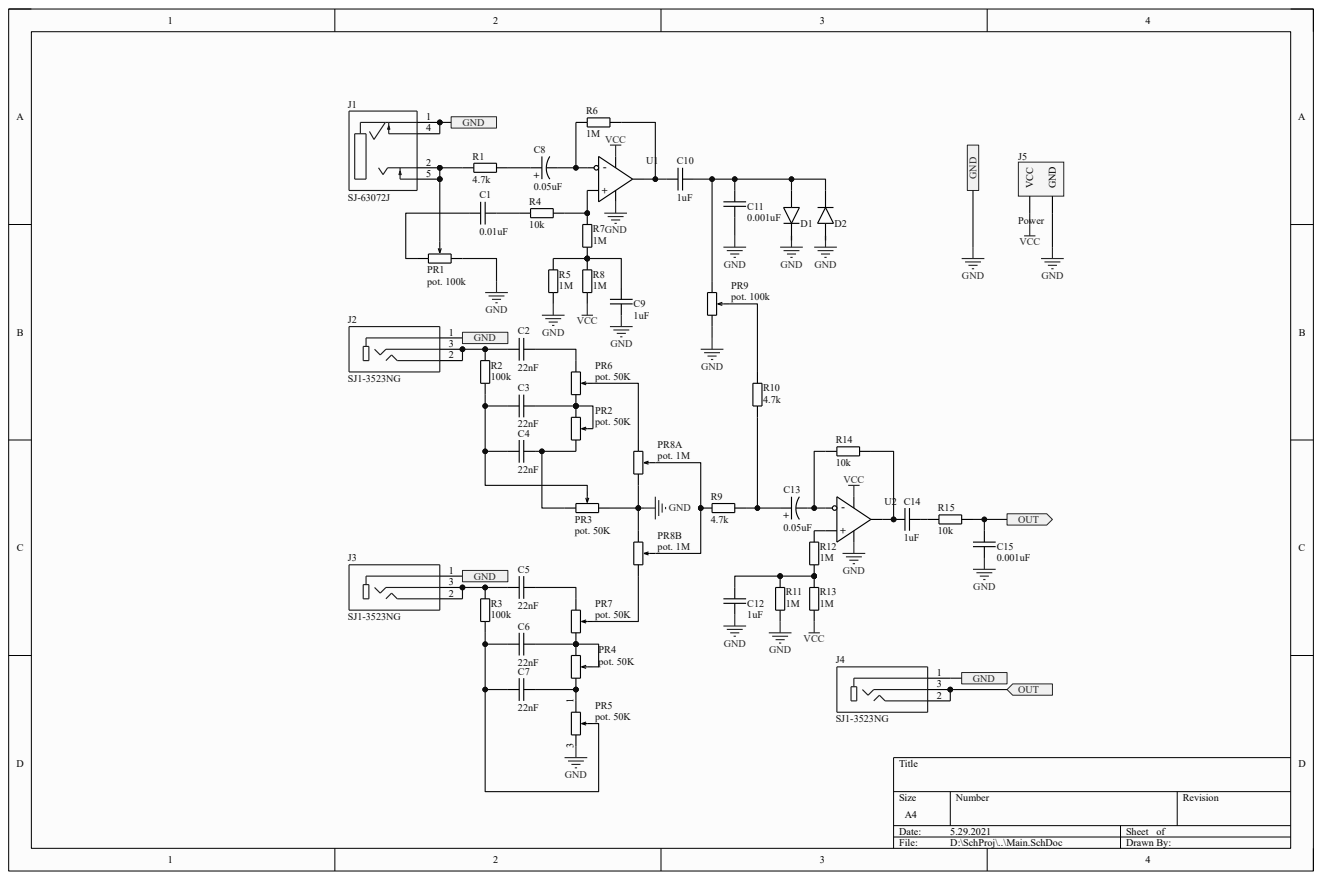
[picture p51: page 1]
