Yegor12345/Analog_electronics/Курсовая работа/LTSpice/КР.asc

C1: cap; 0.01µ
C2: cap; 0.05µ
C3: cap; 1µ
C4: cap; 1µ
C5: cap; 0.001µ
C6: cap; 22n
C7: cap; 22n
C8: cap; 22n
C9: cap; 22n
C10: cap; 22n
C11: cap; 22n
C12: cap; 0.05µ
C13: cap; 1µ
C14: cap; 1µ
C15: cap; 0.001µ
D1: diode; 1N914
D2: diode; 1N914
R1: res; 4.7k
R2: res; 10k
R3: res; 1Meg
R4: res; 10k
R5: res; 1Meg
R6: res; 1Meg
R7: res; 1Meg
R8: res; 100k
R9: res; 100k
R10: res; 4.7k
R11: res; 4.7k
R12: res; 100k
R13: res; 10k
R14: res; 1Meg
R15: res; 1Meg
R16: res; 1Meg
RP1: potentiometer; R=100k
RP2: potentiometer; R=100k
RP3: potentiometer; R=50k
RP4: potentiometer; R=50k
RP5: potentiometer; R=50k
RP6: potentiometer; R=50k
RP7: potentiometer; R=50k
RP8: potentiometer; R=50k
RP9: potentiometer; R=1meg
RP10: potentiometer; R=1meg
U1: LM741
U2: LM741
V1: voltage; 9V
V2: voltage; wavefile=guitar_solo chan=0
V3: voltage; wavefile=guitar_akord chan=0
Named nets: 0, +9V, OUT, IN_MONO, IN_L, IN_P
.wave OUT.wav 16 44100 OUT
.tran 5
