Yegor12345/Analog_electronics/(commit log)

2021-02-07 Create laboratory
    Лабораторні роботи
2021-03-07 Add files via upload
    Перша спроба написання Вступу
2021-05-26 Add files via upload
    Файли симуляції в LTSpice
2021-05-26 Delete Вступ.pdf
    Файл був першою версією
2021-05-26 Add files via upload
    Розрахунково-графічна робота
